c3ll256/itx/product/gallery/528def59-9029-4ea7-bd56-b84e18cdcff9.jpg

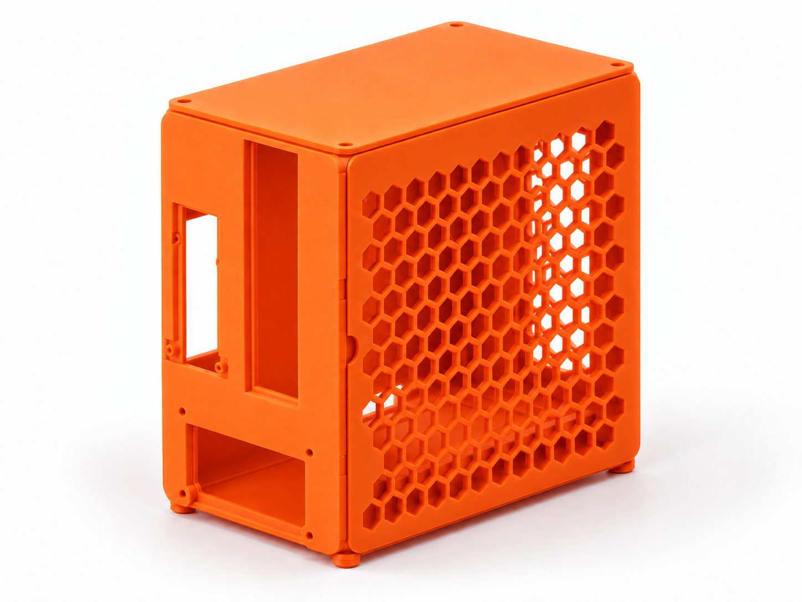
product/gallery/528def59-9029-4ea7-bd56-b84e18cdcff9.jpg
