c3ll256/itx/product/README.md

# 约 10.5 L FDM 打印 Mini‑ITX 机箱 — 产品需求

## 1. 产品目标

设计一款可由桌面 FDM 打印机制造的紧凑型 Mini‑ITX 机箱，优先保证真实硬件可安装、可维护和接口可达。根据实际打印与散热器装机测试，主板侧单边向外加宽 8 mm；当前机箱本体包络固定为 **160 × 260 × 252 mm（约 10.48 L）**，底部 4 mm 脚向下伸出后，安装状态物理包络为 **160 × 260 × 256 mm**。GPU 侧机箱壁、主板、后置 I/O 与 SFX 基准保持不变；显卡垂向基准以显卡双槽开口下边缘和主板后置 I/O 开口下边缘齐平为准。

## 2. 核心硬件兼容性

- 主板：**ASUS ROG STRIX Z390-I GAMING**，Mini‑ITX 170 × 170 mm；采用标准四孔与标准后置 I/O 界面，并保留背面 M.2 器件/螺钉空间。
- CPU 散热器：Thermalright AXP120‑X67，按 123.5 × 120 × 67 mm 名义散热器包络。此前 CAD 没有计入 CPU 与 CPU 基座带来的实际安装厚度；实际装机测得散热器约高出原主板侧板内平面 **4 mm**。因此主板侧相对原版本向外增加 **8 mm**。这里的 8 mm 是机箱加宽量，不是要求安装后仍有至少 8 mm 净余量；按实测关系预计可留下约 4 mm 空间，并继续通过侧板蜂窝孔进风。
- 显卡：**Colorful GeForce RTX 3060 NB DUO 12G V3 L‑V**；按用户实测，本体（不含 PCIe 挡板）为 241 × 132.5 × 41 mm，挡板 L 耳沿长度方向后伸 8.8 mm，CAD 总长度包络为 249.8 mm。双风扇、双槽、8‑pin，倒置安装且 PCIe 金手指朝上。当前显卡槽中心为 X=-43 mm；106 mm 后部双槽开口调整为 Z=84.99..190.99 mm，使其下边缘与主板后置 I/O 开口下边缘同为 Z=84.99 mm。显卡本体按实测保持在挡板基准以下 7.5 mm，下边缘位于 Z=77.49 mm。显卡、前端承托与前面板 80 mm 风扇框体不得干涉。此前 CAD 中的 8-pin 位置代理不准确，不作为碰撞验收依据；用户已确认实物接口不会与当前承托干涉，供电线材方案由用户处理。
- PCIe：采用约 200 mm PCIe 延长线；外侧挂梁位于双槽开口下方，保留约 1 mm 穿板缝和加粗的水平三边半框。
- 显卡远端：U 形承托与可拆前面板内侧一体成型，不增加独立支撑零件；承托保留软垫余量和装配间隙，拆下前面板时沿显卡纵向滑出。
- 电源：标准 SFX，包络 125 × 100 × 63.5 mm；从后部直线推入。后板采用完整四孔安装界面，标准孔距按 113 × 51.5 mm、4 × Ø4.2 mm，并保证孔后批头通道无遮挡。
- 存储：默认使用主板 M.2；不要求独立 2.5/3.5 英寸硬盘位。
- 机箱风扇：前面板靠主板侧设置两个 80 mm 进风位，底板靠前设置一个 120 mm 进风位；保留 71.5 mm / 105 mm 标准固定孔方距，三处均采用连续外圈、约 3 mm 或更宽打印筋和圆头长槽的一体式格栅。

## 3. 主板安装要求

- 主板不得直接贴住大面积机箱壁面；四个安装点必须提供约 **6.35 mm** 的 PCB 背面结构间隙。
- 保留三个约 6.35 mm 高的一体打印主板支撑点：后下支撑与后板一体，前后两个上支撑与顶盖一体；底部前方支撑点按用户要求删除。不得再安装独立铜柱、热熔螺母或其他额外主板隔离柱。
- 主板使用三颗 M3 螺钉，从可接近的一侧穿过 PCB 安装孔，直接拧入打印支撑点内的自成型孔。
- 所有进入打印件的 M3 主板孔必须由 `printed-screw-joint-v1` 生成，不得手工绘制普通圆孔或名义 ISO 螺纹孔。
- 打印支撑点需要足够的孔深、径向壁厚和根部过渡，避免首次装配时开裂；螺钉不得穿透支撑点后顶到其他部件。
- 主板安装后，标准后置 I/O 必须完整穿过后板开口；PCB 板框不得顶住顶盖、底板或后板。
- 装配顺序至少应验证：拆下侧板后侧向送入主板、在前移位置贴近安装面、向后滑入 I/O 开口、三颗保留螺钉均可沿安装轴线接近。
- 主板已锁定为 ASUS ROG STRIX Z390-I GAMING；本次按其 Mini‑ITX 170 × 170 mm 板框、标准四孔、标准后置 I/O、双 DIMM/PCIe 布局与背面 M.2 区域复核。未取得厂商 STEP，因此 CAD 中使用机械包络与区域代理，不声称逐器件外形复刻。

## 4. 外壳、面板与固定

- 外壳保持六面板主体结构，并增加四个独立打印的底脚；外宽 160 mm、外深 260 mm、总高 252 mm，脚向下伸出 4 mm。新增的 8 mm 全部位于主板侧，GPU 侧机箱壁位置不动。
- 两侧板采用大面积通风网孔，使 CPU 散热器和显卡从侧面取风。
- 正面为可拆面板，左上角使用用户指定的天猫商品 **655230136762** 电源按钮（中心 X=+50 mm、Z=227 mm；从机箱正面观察为左侧）。用户重新查看商品规格后确认所选按钮是 **Φ8 mm 安装规格**；前面板暂定 FDM 打印开孔为 **Ø8.2 mm**（0.2 mm 名义直径余量）。生产打印前须用收到的实物复测螺纹安装段外径并校准打印孔；当前 CAD 不提供按钮本体、按钮帽、执行件或内部走线结构。
- 前、左、右外围面板采用磁吸固定；背板使用螺钉固定。
- 前、后端板共设置八个 **10 × 5 × 2 mm** 矩形磁铁，采用胶粘安装，不使用磁铁固定螺丝。磁铁槽平面尺寸为 **10.5 × 5.5 mm**，长度与宽度各保留 0.5 mm 总安装余量；槽深保持 **2.0 mm**，使磁铁粘到底后与开口齐平。每处仅保留紧凑的局部槽座，删除外围大框、叠层护板和隐藏连接颈；左右侧板保留对应钢片吸附件，且磁铁腔、承载壁及钢片结构不得侵入硬件包络。
- 顶盖、底板和背板的承力连接可使用标准螺钉；不得仅依赖磁力或薄壁卡扣。
- 顶板与底板的四个角部外露固定点均使用 **M3 内六角锥形沉头螺钉**及匹配的锥形沉头孔，装好后螺钉头与外表面齐平；不得使用圆柱形沉孔。当前 CAD 由 `printed-screw-joint-v1` 解算为顶板 4 × M3 × 10、底部 4 × M3 × 12。用户实测沉头螺丝头最大直径为 **5.8 mm**。顶盖入口保持约 **Ø6.12 mm**；根据用户对脚底外层入口的装配反馈，采用 **Ø6.5 mm 最小入口**作为公开的 FDM 装配余量默认值，四个底脚入口当前实测 **Ø6.717 mm**，相对螺丝头保留约 **0.917 mm 总直径余量（单边约 0.459 mm）**。底脚仍使用工具生成的锥形切削体，偏置由 0.20 mm 提高到 0.45 mm，没有改成圆柱形沉孔。四个 Ø16 × 4 mm 底脚分别独立打印，上下外缘使用 1.2 mm 圆角；入口处圆角外圈为 Ø13.6 mm，最薄径向材料仍约 3.44 mm。每颗底部螺钉从脚底装入，沉头座额外下沉 1.2 mm，使同一颗 M3 × 12 增加 1.2 mm 有效伸入长度，再依次穿过脚和底板并拧入对应前面板或后面板的下部打印固定块，用一颗螺钉同时夹紧脚、底板和端板。

## 5. SFX 与后部服务面

- SFX 插入包络及约 0.8 mm 侧面/顶部装配余量内不得有角块、固定块或其他结构干涉。
- 后面板的 SFX 四孔必须完整，孔后不得被圆台、墙体或其他零件遮挡；需保留批头直线通道。
- GPU 后部双槽开口高度保持 106 mm，范围为 Z=84.99..190.99 mm；其下边缘与主板后置 I/O 开口下边缘齐平。双槽 GPU 为倒置方向，PCIe 金手指朝上。
- 外侧 PCIe 梁保留约 1 mm 穿板缝；横跨开口的水平三边半框净缝 1.0 mm，梁宽和厚度以 2.4 mm 为当前结构基准。

## 6. 性能、安全与可制造性

- 所有硬件均不得按零间隙名义装配；线材、显卡供电、散热器进风、SFX 插入和可拆部件需有明确余量。
- 电源进风、排风和交流输入区域不得被打印件或线材遮挡。
- 打印件不得紧贴高温散热表面；推荐 PETG、ABS 或 ASA，不建议普通 PLA 作为高温长期使用材料。
- M3 自成型塑料孔适合正常安装维护，但不以高频反复拆装为目标；装配说明应注明避免过度拧紧。

## 7. 验证与验收

- 使用 ROG STRIX Z390-I GAMING 的 170 × 170 mm 板框、标准四孔、标准 I/O 代理和背面 M.2_2 保留区检查最终坐姿及两步装入路径。
- 验证机箱总外宽为 160 mm，主板侧相对上一版单边外移 8 mm，GPU 侧机箱壁及主板、后置 I/O、SFX 基准未移动；显卡垂向位置以显卡双槽开口下边缘和主板后置 I/O 开口下边缘齐平为准。实际散热器约高出原侧板内平面 4 mm；本项以单边外移 8 mm 为验收条件，不要求 CAD 简化参考包络至新侧板内表面仍保留至少 8 mm。
- 验证三个保留的一体打印支撑点共面、约 6.35 mm 背面间隙、M3 螺钉轴线可达；同时确认已删除的底部前方固定点没有残留底板通孔，以及板框与底板/顶盖/后板无体积干涉。
- 验证 SFX 后部直线插入、四孔与批头通道，以及 Colorful 用户实测 241 × 132.5 × 41 mm 显卡本体、249.8 mm 含挡板耳总包络、Z=84.99..190.99 mm 的 106 mm 双槽开口、显卡开口与主板后置 I/O 开口下边缘同为 Z=84.99 mm、显卡本体下边缘 Z=77.49 mm、双风扇侧向进风、PCIe 下置挂梁和前面板一体式远端 U 形承托；承托每侧至少保留 1 mm 装配余量，并能随前面板沿显卡纵向退出。此前错误的 8-pin 位置代理不参与碰撞验收；实物接口与承托不干涉由用户的物理确认作为当前依据。
- 验证前面板两个 80 mm 和底板一个 120 mm 风扇位的标准固定孔、连续外圈与圆头长槽格栅；格栅不得产生断裂薄筋或尖锐内角。
- 删除所有临时适配量规后，再做六面板多视角装配检查。
- 正式 CAD Review 在 CAD handoff 导出边界运行；电源按钮验收按用户确认的 Φ8 mm 商品变体检查暂定 Ø8.2 mm 安装孔，并要求生产打印前以实物复测和打印孔校准结果复核；不得因按钮本体、按钮帽、执行件或走线未建模而判定失败。未通过评审和交付导出前，不得把检查修订称为可打印最终版。

## 8. 交付物

- 完整可视化装配 CAD。
- 最终精确修订的 STEP 制造交付；GLB 预览由 STEP 派生刷新。
- 关键尺寸、装配顺序、推荐打印方向、材料和紧固件说明。
- STL/3MF 与打印排版不属于本 CAD Workbench 交付格式。

## 9. 已确认选型与采购边界

- 已确认：Colorful GeForce RTX 3060 NB DUO 12G V3 L‑V；显卡供电线材方案由用户处理。此前 CAD 中的 8-pin 位置代理错误，用户确认实物接口不会与当前前端承托干涉。
- 已确认：ASUS ROG STRIX Z390-I GAMING。
- 已确认：主板直接安装到一体打印支撑点，使用 M3 自成型塑料孔；不使用热熔螺母或独立固定柱。
- 已确认：标准 SFX 包络设计。
- 电源兼容边界锁定为标准 SFX 125 × 100 × 63.5 mm；主板、显卡和散热器锁定为本版所列型号与规格。
- 本项目不包含定制 PCB。
