c3ll256/itx/product/gallery/cover-iso.jpg

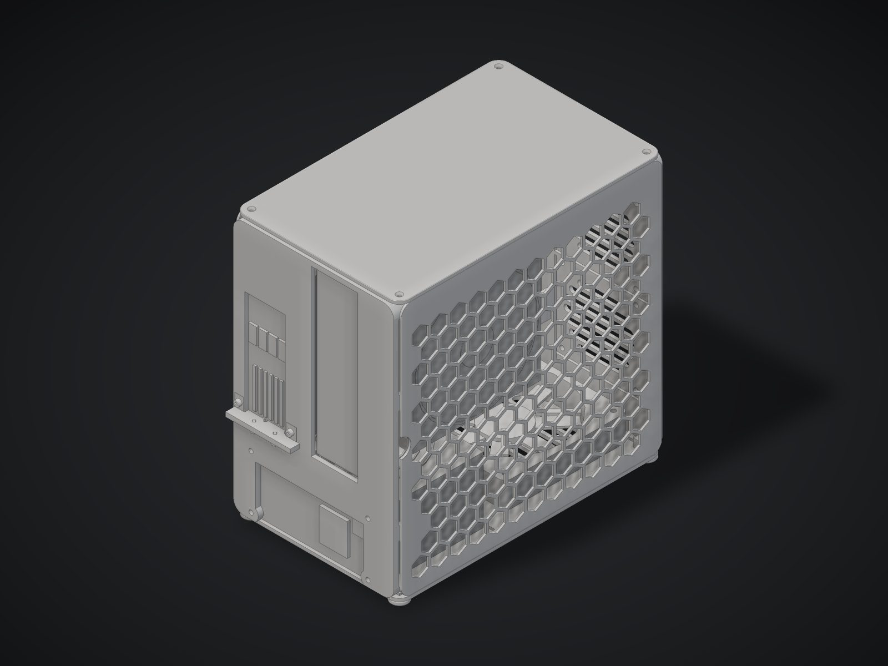
product/gallery/cover-iso.jpg
