c3ll256/itx/workspace/.scratch/mitx-crops/bottom.png

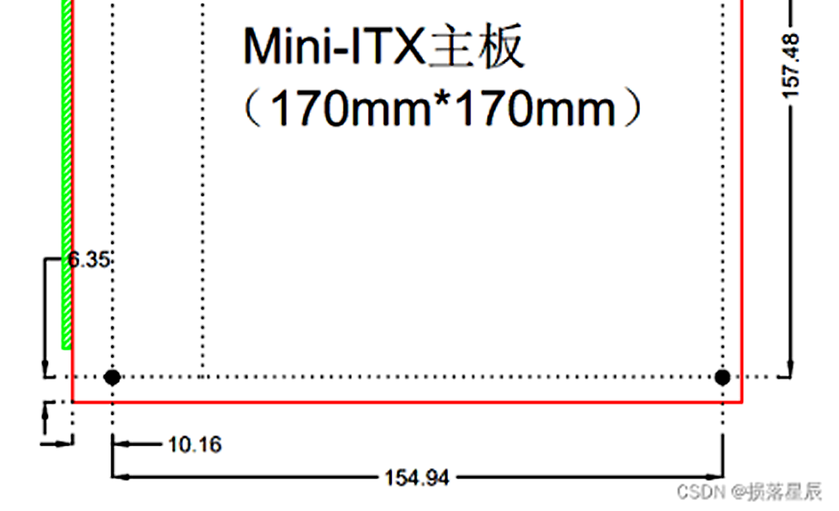
workspace/.scratch/mitx-crops/bottom.png
