c3ll256/itx/workspace/.scratch/mitx-crops/center.png

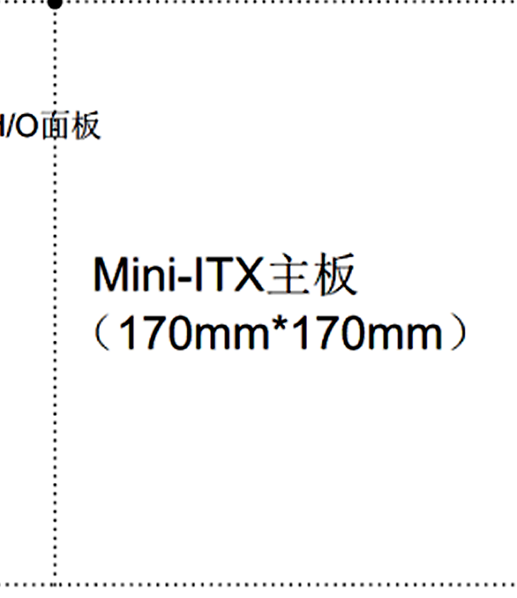
workspace/.scratch/mitx-crops/center.png
