c3ll256/itx/workspace/.scratch/mitx-crops/left.png

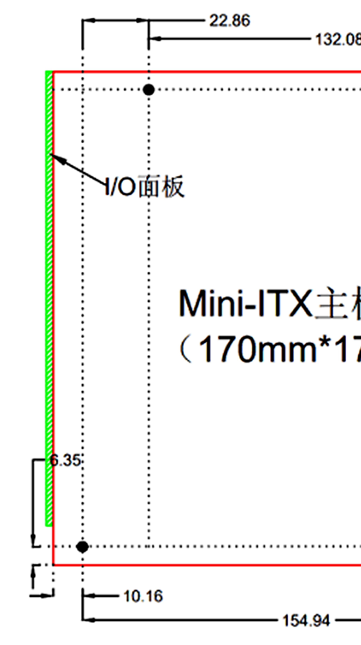
workspace/.scratch/mitx-crops/left.png
