c3ll256/itx/workspace/.scratch/mitx-crops/right.png

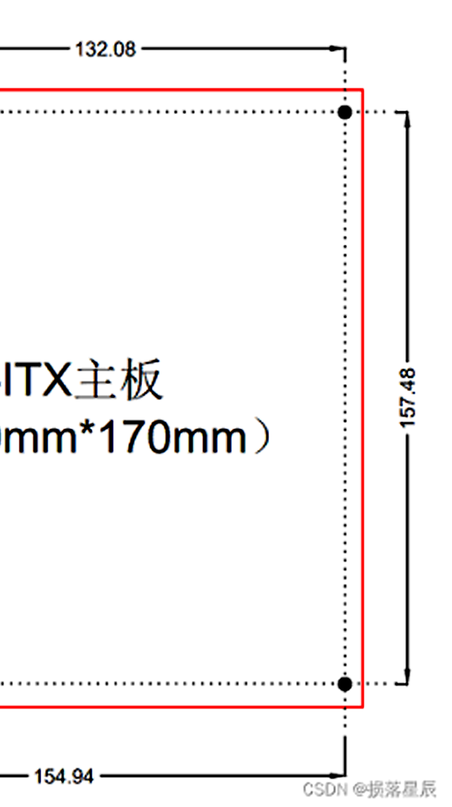
workspace/.scratch/mitx-crops/right.png
