c3ll256/itx/workspace/.scratch/mitx-crops/top.png

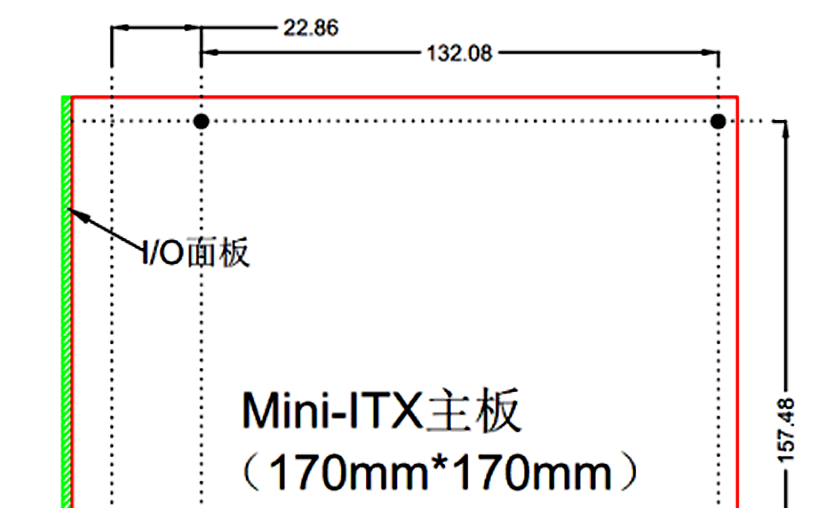
workspace/.scratch/mitx-crops/top.png
