c3ll256/itx/manufacturing/enclosure-integrated/releases/export-d511700a9985e37678db4157f0b6202b/model.step

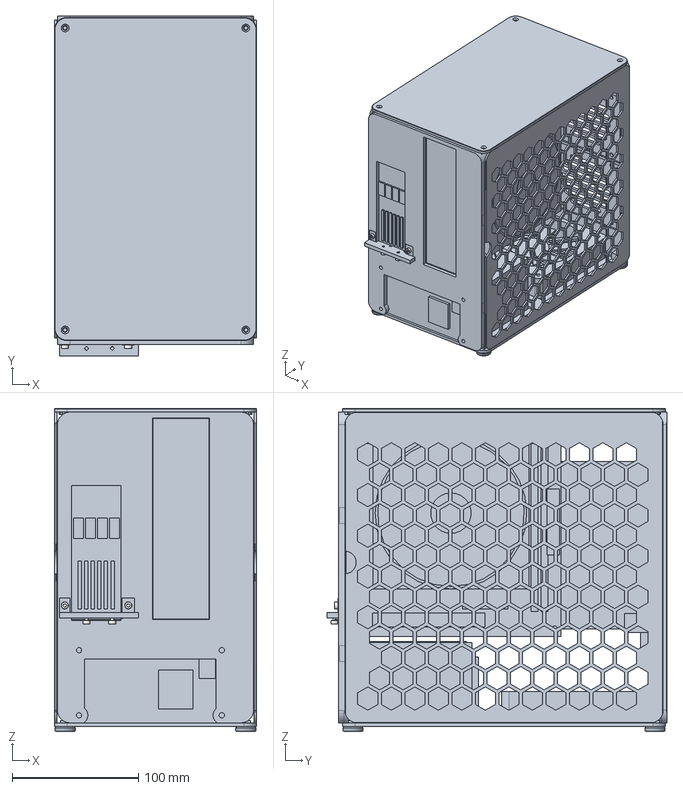
[picture p8: CAD file, 2026-09-06]
manufacturing/enclosure-integrated/releases/export-d511700a9985e37678db4157f0b6202b/model.step
160.0 x 269.1 x 256.0 mm
base
top_cap
front_panel
rear_panel
left_panel
Outward_motherboard-side_panel
pcie_bracket
base_foot_rear_left
base_foot_rear_right
base_foot_front_left
base_foot_front_right
Rear-left_foot_screw
Rear-right_foot_screw
Front-left_foot_screw
Front-right_foot_screw
mitx_pcb
ATX_I-O_fit_envelope
CPU_socket_envelope
PCIe_x16_slot
24-pin_ATX_header
CPU_power_header
Chipset_heatsink
AXP120-X67_envelope
ROG_backside_M_2_keepout
sfx_chassis
AC_inlet_reference
PSU_switch_reference
Modular_cable_bank
Colorful_GPU_body
Colorful_GPU_PCB
Flipped_dual-slot_bracket
Upward_PCIe_fingers
