c3ll256/itx/(commit log)

2026-08-17 checkpoint: base before query 6fd50776-cbcf-4376-b69c-2845d8ef4e83
    [5a66f00f8ed6251e5fdb97fe219144e5017251f717f0bb2728ed4b57b4606fa3.step]
2026-08-18 feat(cad): add Mini-ITX mount fit coupon
    [mitx-lower-front-mount-fit-test.step]
2026-08-18 Revert "feat(cad): add Mini-ITX mount fit coupon"
    This reverts commit 3d68fbbf77d85fa674e06d558503563a9c4b6892.
    [mitx-lower-front-mount-fit-test.step]
2026-08-18 fix(product): restore CAD contract after rollback
2026-08-18 fix(cad): rebuild standard mini-itx io shield reference
2026-08-18 fix(cad): align mini-itx io shield datum
2026-08-18 fix(cad): reference mini-itx io from solder face
2026-08-18 fix(cad): align rear io aperture to solder face
2026-08-18 fix(cad): raise and loosen mini-itx io shield fit
2026-08-18 fix(cad): shift itx mount holes 1 mm for real shield thickness
2026-08-20 fix(cad): correct gpu fit and add fan mounts
2026-08-20 feat(cad): add rounded fan grilles
2026-08-20 fix(cad): move power switch to front upper left
2026-08-20 fix(cad): raise pcie retention bracket clearance
2026-08-20 fix(cad): move gpu slot inward for screw clearance
2026-08-20 feat(cad): add base fan fit reference
2026-08-21 fix(cad): align PCIe retention holes
2026-08-21 fix(cad): tighten PCIe retention bracket
2026-08-21 fix(cad): simplify front GPU support
2026-08-21 fix(cad): extend front GPU support
2026-08-21 fix(cad): remove narrow GPU support edge
2026-08-21 feat(cad): reinforce front and rear panels
2026-08-21 feat(cad): add 5mm panel reinforcement
2026-08-23 feat(cad): add GPU cradle side restraints
2026-08-23 feat(cad): round panels and revise magnetic mounts
2026-08-23 fix(cad): simplify enclosure panel interfaces
2026-08-23 fix(cad): clean panel magnet interfaces
2026-08-23 fix(cad): unify rear magnet panel skin
2026-08-23 fix(hardware): sync BOM with current enclosure
2026-08-23 fix(cad): simplify panel magnet interfaces
2026-08-23 fix(cad): simplify motherboard I-O rebate
2026-08-23 fix(cad): simplify front magnet carriers
2026-08-23 fix(cad): remove obsolete front magnet geometry
2026-08-24 fix(cad): clean side panel geometry
2026-08-24 fix(cad): add alternate PCIe mounting holes
2026-08-24 fix(cad): move alternate PCIe slots to edge
2026-08-26 docs(product): select 10mm power button
2026-08-26 docs(product): confirm 8mm power button
2026-08-26 fix(cad): enlarge bottom foot screw entries
2026-08-28 fix(cad): key PCIe bracket and reposition holes
2026-08-28 fix(cad): clear PCIe bracket and add threaded holes
2026-08-28 fix(cad): pocket rear panel around PCIe bracket
2026-08-28 revert(cad): remove rear panel PCIe pockets
2026-08-28 revert(cad): restore keyed PCIe bracket
2026-08-28 fix(cad): thread PCIe bracket holes
2026-08-28 fix(cad): shift outer PCIe holes
2026-09-06 chore: commit project files for publishing
    [5a66f00f8ed6251e5fdb97fe219144e5017251f717f0bb2728ed4b57b4606fa3.step]
2026-09-06 chore: ship the manufacturing package with the project
    The listing is meant to hand somebody something they can print, and a
    clone that carries only sources leaves them looking at an empty
    manufacturing directory. Switch the artifacts policy to `included`,
    which drops the `manufacturing/**` rules from the managed ignore block,
    and commit the enclosure release STEP that was already on disk.
    [model.step]
